a-rahimi/Touch-Panel/pcb/renders/back.png

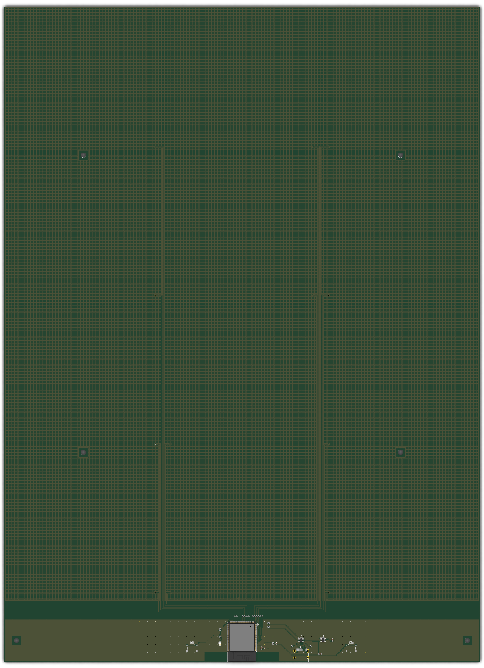
pcb/renders/back.png
