a-rahimi/Touch-Panel/pcb/touch_panel.kicad_pcb

## KiCad design pcb/touch_panel.kicad_pcb (2026-10-31)

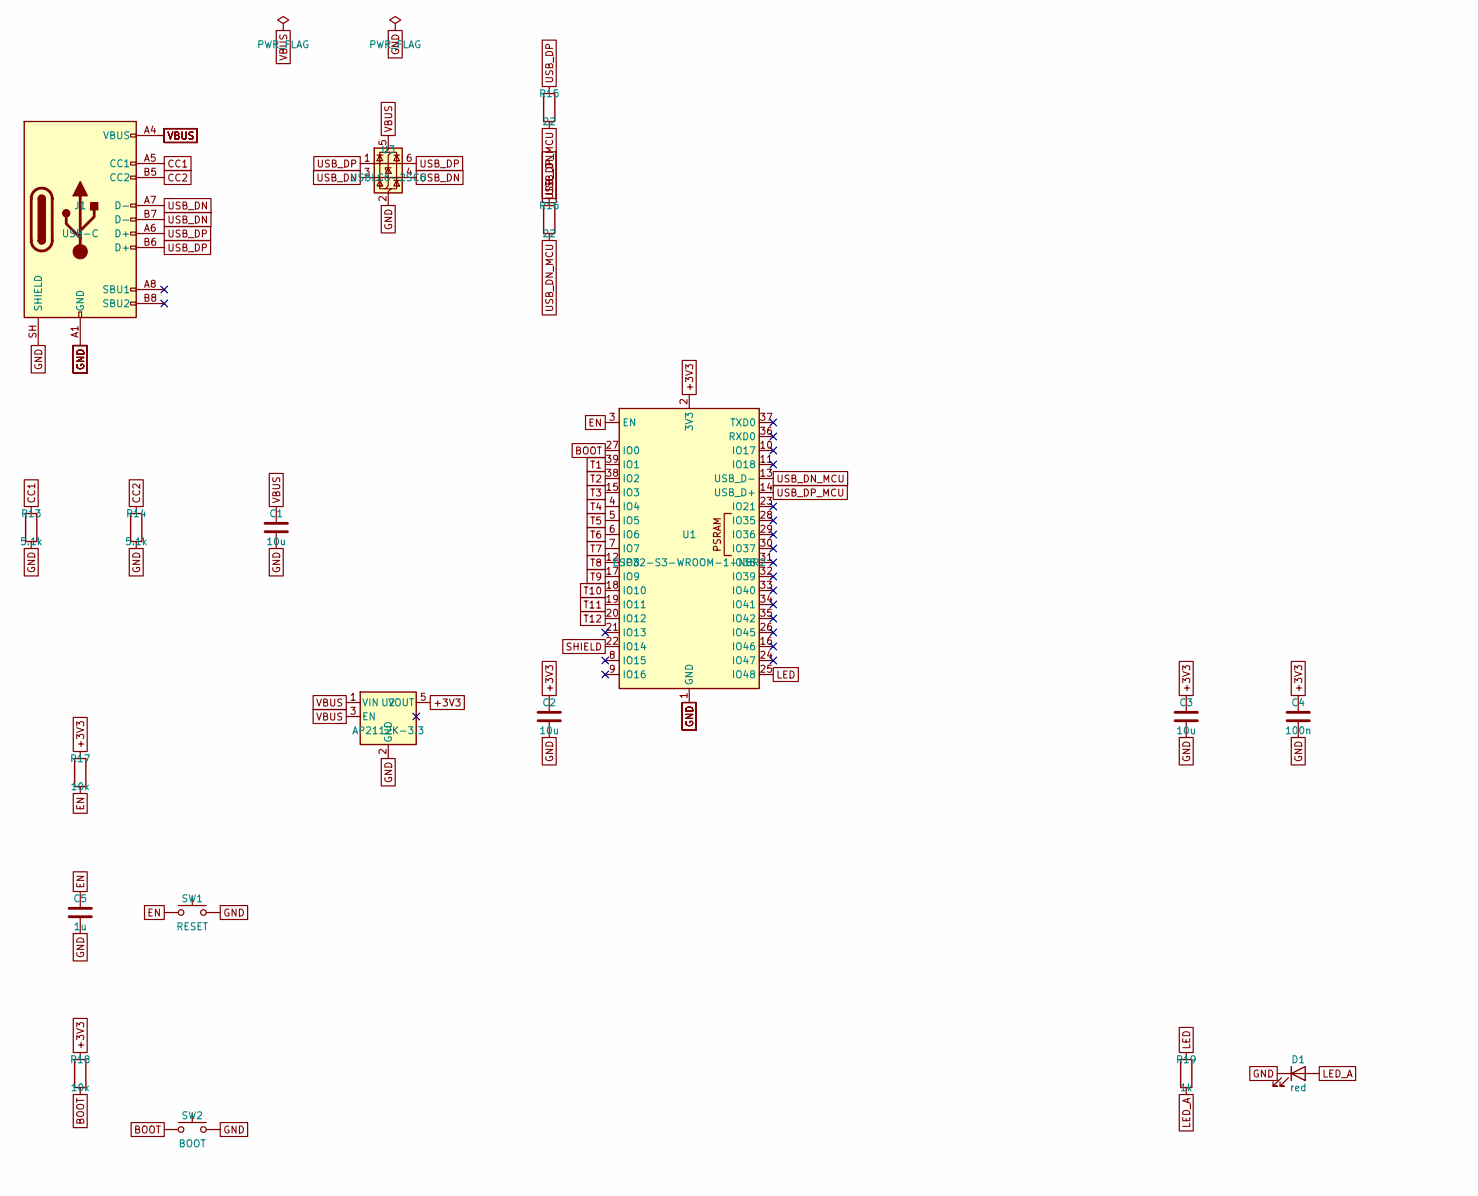
[picture p3: schematic touch_panel.kicad_sch, Touch panel, part in row 1, column 1]

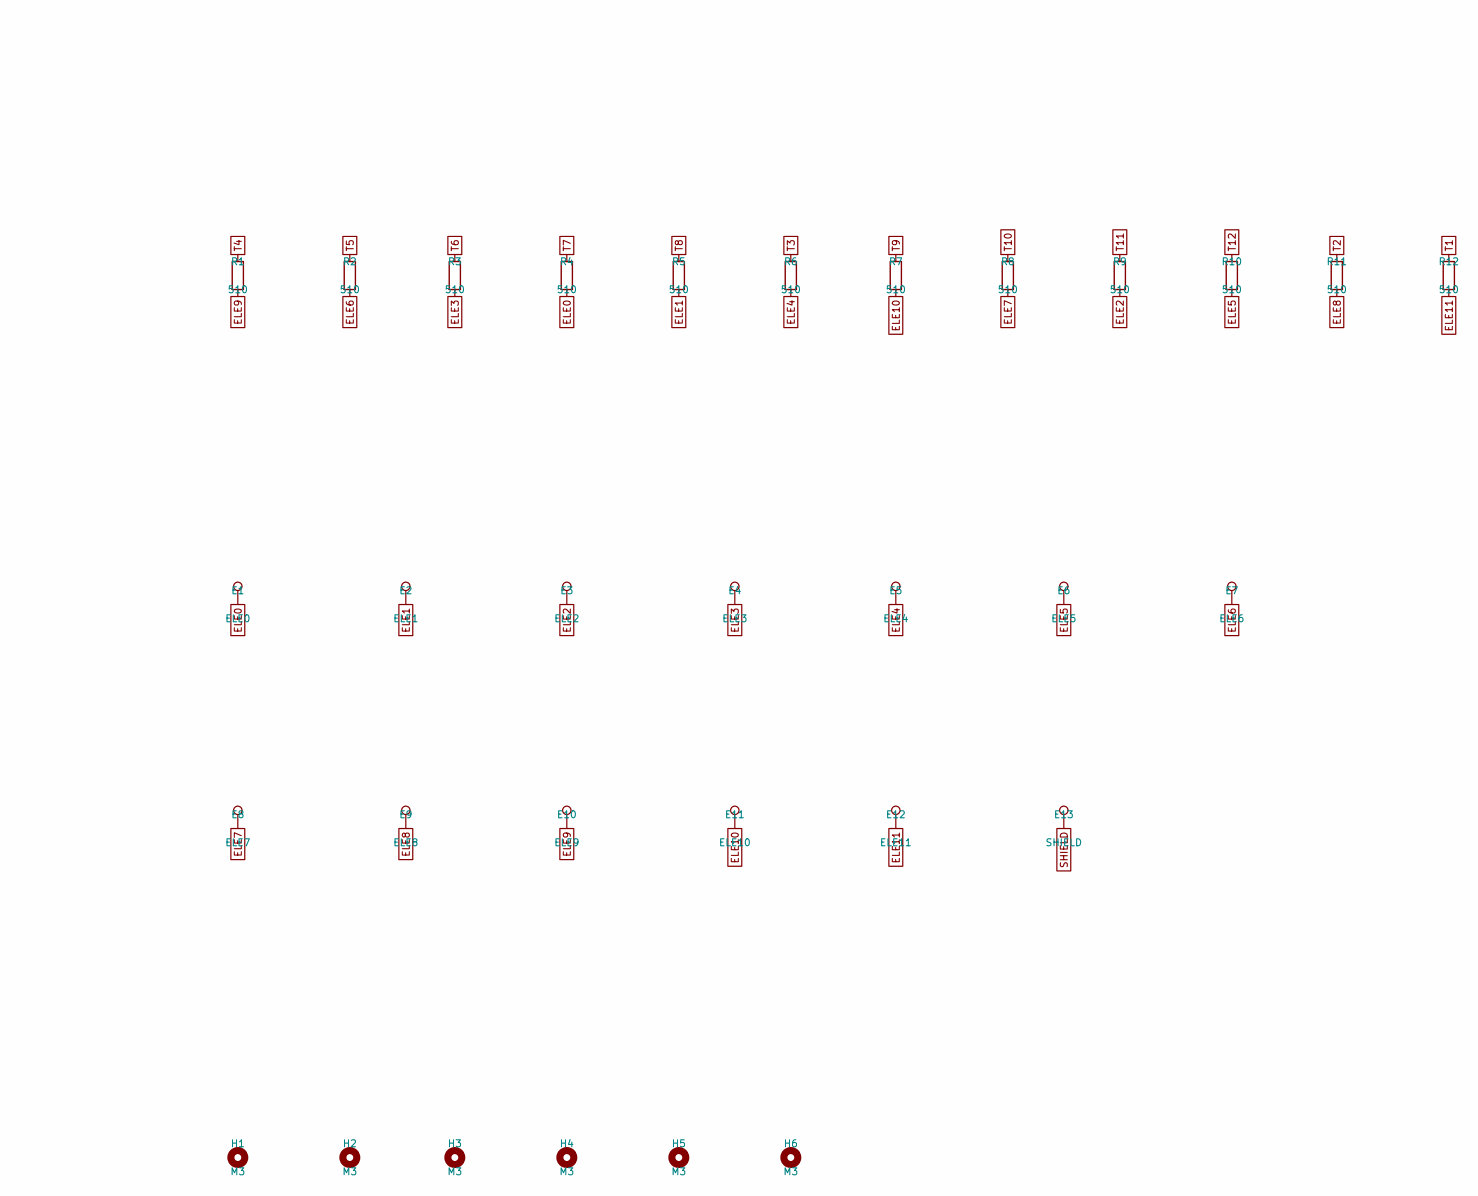
[picture p4: schematic touch_panel.kicad_sch, Touch panel, part in row 1, column 2]

Parts:
C1, C2, C3: 10u; C_0603_1608Metric; LCSC C19702
C4: 100n; C_0402_1005Metric; LCSC C1525
C5: 1u; C_0402_1005Metric; LCSC C52923
D1: red; LED_0603_1608Metric; LCSC C2286
E1: ELE0; Electrode
E2: ELE1; Electrode
E3: ELE2; Electrode
E4: ELE3; Electrode
E5: ELE4; Electrode
E6: ELE5; Electrode
E7: ELE6; Electrode
E8: ELE7; Electrode
E9: ELE8; Electrode
E10: ELE9; Electrode
E11: ELE10; Electrode
E12: ELE11; Electrode
E13: SHIELD; ShieldTap
H1, H2, H3, H4, H5, H6: M3; MountingHole_3.2mm_M3
J1: USB-C; USB_C_Receptacle_HRO_TYPE-C-31-M-12; LCSC C165948
R1, R2, R3, R4, R5, R6, R7, R8, R9, R10, R11, R12: 510; R_0402_1005Metric; LCSC C25123
R13, R14: 5.1k; R_0402_1005Metric; LCSC C25905
R15, R16: 22; R_0402_1005Metric; LCSC C25092
R17, R18: 10k; R_0402_1005Metric; LCSC C25744
R19: 1k; R_0402_1005Metric; LCSC C11702
SW1: RESET; SW_Push_1P1T_XKB_TS-1187A; LCSC C318884
SW2: BOOT; SW_Push_1P1T_XKB_TS-1187A; LCSC C318884
U1: ESP32-S3-WROOM-1-N8R2; ESP32-S3-WROOM-1; LCSC C2913204
U2: AP2112K-3.3; SOT-23-5; LCSC C51118
U3: USBLC6-2SC6; SOT-23-6; LCSC C7519

Connections:
+3V3: C2.1, C3.1, C4.1, R17.1, R18.1, U1.2 (3V3), U2.5 (VOUT)
BOOT: R18.2, SW2.1, U1.27 (IO0)
CC1: J1.A5 (CC1), R13.1
CC2: J1.B5 (CC2), R14.1
ELE0: E1.1, R4.2
ELE1: E2.1, R5.2
ELE2: E3.1, R9.2
ELE3: E4.1, R3.2
ELE4: E5.1, R6.2
ELE5: E6.1, R10.2
ELE6: E7.1, R2.2
ELE7: E8.1, R8.2
ELE8: E9.1, R11.2
ELE9: E10.1, R1.2
ELE10: E11.1, R7.2
ELE11: E12.1, R12.2
EN: C5.1, R17.2, SW1.1, U1.3 (EN)
GND: C1.2, C2.2, C3.2, C4.2, C5.2, D1.1 (K), J1.A1 (GND), J1.A12 (GND), J1.B1 (GND), J1.B12 (GND), J1.SH (SHIELD), R13.2, R14.2, SW1.2, SW2.2, U1.1 (GND), U1.40 (GND), U1.41 (GND), U2.2 (GND), U3.2 (GND)
LED: R19.1, U1.25 (IO48)
LED_A: D1.2 (A), R19.2
SHIELD: E13.1, U1.22 (IO14)
T1: R12.1, U1.39 (IO1)
T2: R11.1, U1.38 (IO2)
T3: R6.1, U1.15 (IO3)
T4: R1.1, U1.4 (IO4)
T5: R2.1, U1.5 (IO5)
T6: R3.1, U1.6 (IO6)
T7: R4.1, U1.7 (IO7)
T8: R5.1, U1.12 (IO8)
T9: R7.1, U1.17 (IO9)
T10: R8.1, U1.18 (IO10)
T11: R9.1, U1.19 (IO11)
T12: R10.1, U1.20 (IO12)
USB_DN: J1.A7 (D-), J1.B7 (D-), R16.1, U3.3 (I/O2), U3.4 (I/O2)
USB_DN_MCU: R16.2, U1.13 (USB_D-)
USB_DP: J1.A6 (D+), J1.B6 (D+), R15.1, U3.1 (I/O1), U3.6 (I/O1)
USB_DP_MCU: R15.2, U1.14 (USB_D+)
VBUS: C1.1, J1.A4 (VBUS), J1.A9 (VBUS), J1.B4 (VBUS), J1.B9 (VBUS), U2.1 (VIN), U2.3 (EN), U3.5 (VBUS)

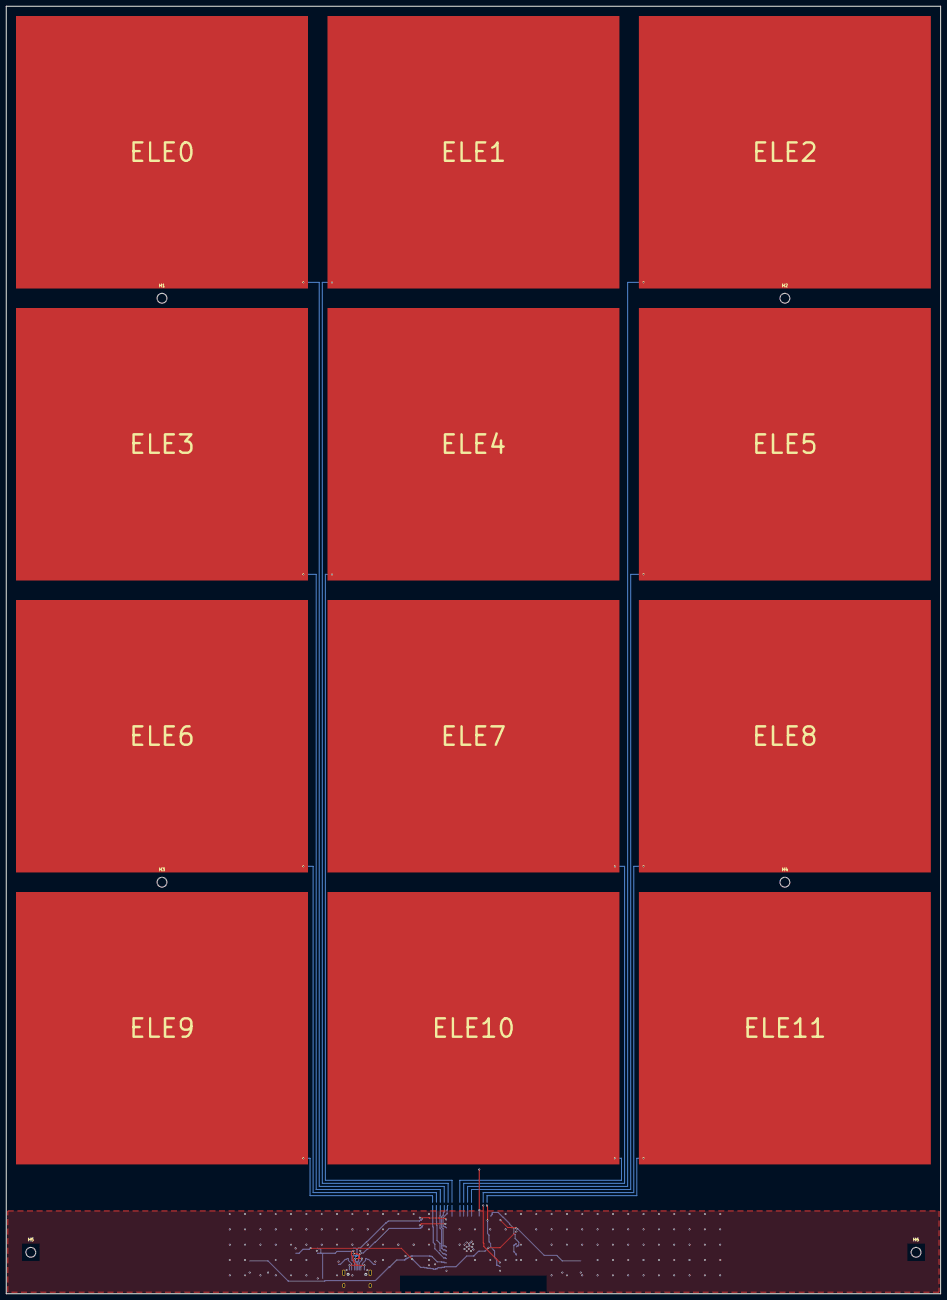
[picture p5: board touch_panel.kicad_pcb from above]

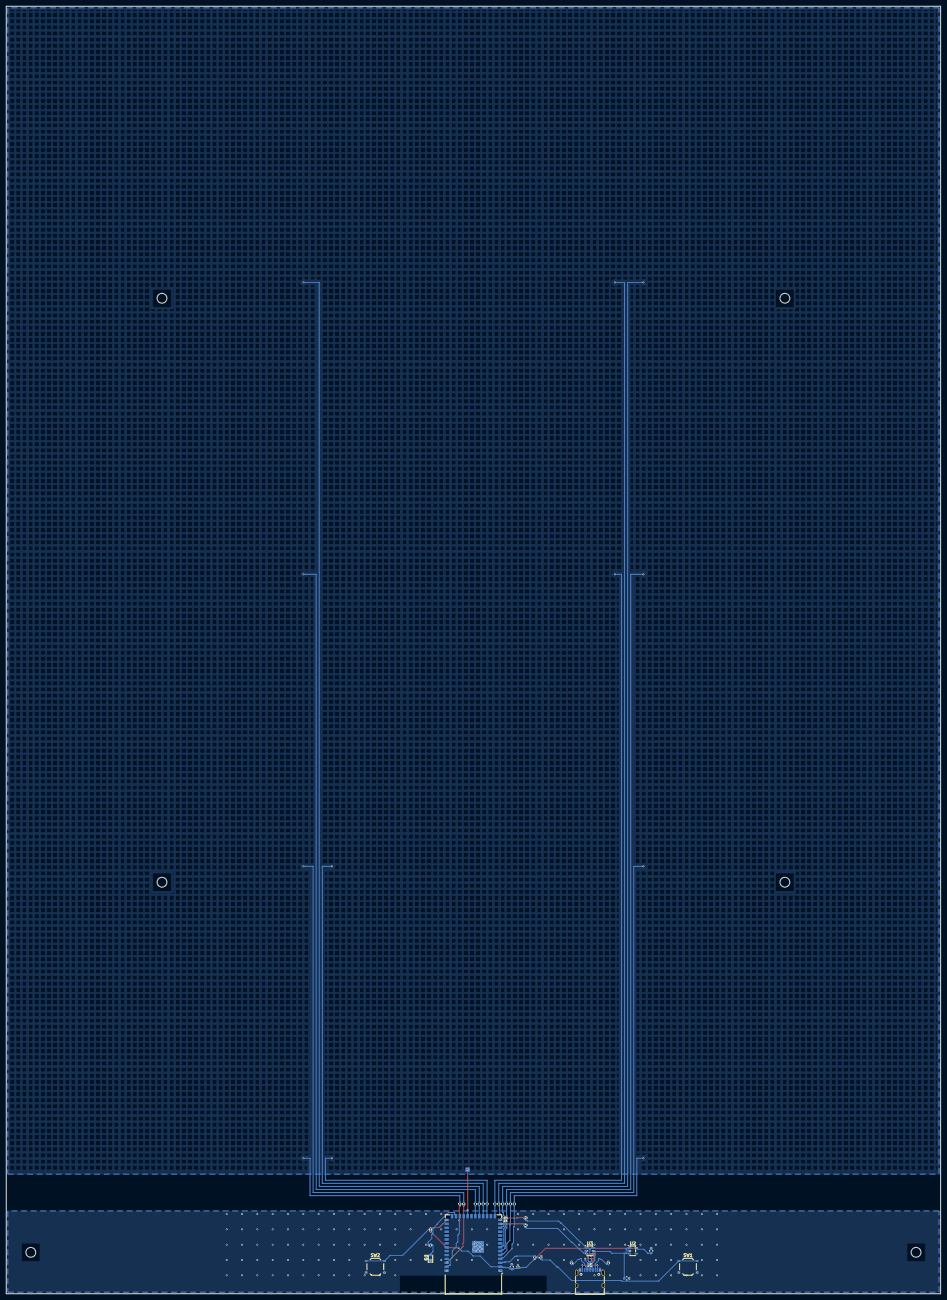
[picture p6: board touch_panel.kicad_pcb from below]

Board: 2 copper layers, 304.8 x 420.0 mm, 50 parts (32 on the bottom side), 38 nets.
