a-rahimi/Touch-Panel/firmware/main/wifi.c

#include "wifi.h"
#include <stdio.h>
#include <string.h>
#include "esp_event.h"
#include "esp_netif.h"
#include "esp_wifi.h"
#include "nvs_flash.h"

#include "wifi_secrets.h" /* WIFI_SSID and WIFI_PASSWORD, kept out of git */

static char address[16];
static volatile bool connected;

static void on_event(void *arg, esp_event_base_t base, int32_t id, void *data)
{
    if (base == WIFI_EVENT && (id == WIFI_EVENT_STA_START || id == WIFI_EVENT_STA_DISCONNECTED)) {
        connected = false;
        esp_wifi_connect();
    } else if (base == IP_EVENT && id == IP_EVENT_STA_GOT_IP) {
        ip_event_got_ip_t *e = data;
        snprintf(address, sizeof address, IPSTR, IP2STR(&e->ip_info.ip));
        connected = true;
    }
}

void wifi_start(void)
{
    esp_err_t err = nvs_flash_init();
    if (err == ESP_ERR_NVS_NO_FREE_PAGES || err == ESP_ERR_NVS_NEW_VERSION_FOUND) {
        nvs_flash_erase();
        nvs_flash_init();
    }
    esp_netif_init();
    esp_event_loop_create_default();
    esp_netif_create_default_wifi_sta();
    wifi_init_config_t init = WIFI_INIT_CONFIG_DEFAULT();
    esp_wifi_init(&init);
    esp_event_handler_register(WIFI_EVENT, ESP_EVENT_ANY_ID, on_event, NULL);
    esp_event_handler_register(IP_EVENT, IP_EVENT_STA_GOT_IP, on_event, NULL);

    wifi_config_t cfg = {0};
    strncpy((char *)cfg.sta.ssid, WIFI_SSID, sizeof cfg.sta.ssid);
    strncpy((char *)cfg.sta.password, WIFI_PASSWORD, sizeof cfg.sta.password);
    esp_wifi_set_mode(WIFI_MODE_STA);
    esp_wifi_set_config(WIFI_IF_STA, &cfg);
    esp_wifi_start();
}

const char *wifi_ssid(void) { return WIFI_SSID; }

const char *wifi_address(void) { return connected ? address : NULL; }
