a-rahimi/Touch-Panel/(commit log)

2026-10-31 Touch panel: printed pad tray, MPR121 firmware and Mac tools
    A 12 x 15 inch tray of 12 copper pads, read by an MPR121 and a XIAO ESP32-C3.
    The firmware tracks the hand's centroid over the pads, matches the gesture
    2+1+0+1+2+ to toggle a Kasa switch over Wi-Fi, and reports the centroid over
    Bluetooth LE. The Wi-Fi credentials come from firmware/.env, which git ignores.
    [tray.scad]
2026-10-31 Design the panel as one ESP32-S3 PCB, and build the firmware for either board
    pcb/ holds a 2-layer, 304.8 x 420 mm board generated from Python: 12 pads in
    top copper under mask, traces down the gaps between pad columns, a hatched
    shield on GPIO14 under the pads, and an ESP32-S3-WROOM-1 strip with USB-C,
    regulator and buttons. It passes KiCad's ERC and DRC with schematic parity.
    pcb/tools/make_fab.py writes JLCPCB gerbers, BOM and placement.
    The firmware reads its pads through sensor.h: mpr121.c on the XIAO ESP32-C3,
    s3_touch.c on the S3 board. firmware/tools/build.sh builds either.
    [touch_panel.kicad_pcb, touch_panel.kicad_sch]
2026-10-31 Put every part on the back of the PCB, leaving the front only pads
    The front is now flat, so the board can lie against a desk. The module is
    mirrored on the back, so the touch resistors and the pad-to-touch-pin
    assignment are remapped to keep the traces uncrossed; the pad traces stay on
    the bottom layer to their resistors, and the shield trace crosses them on
    the top. The USB-C breakout is mirrored onto the bottom layer, the fab
    placement file lists the bottom side, and the S3 firmware's channel table
    follows the new assignment. ERC and DRC pass, with schematic parity.
    [touch_panel.kicad_pcb, touch_panel.kicad_sch]
